ben4096/radpower-parts/README.md

# Radpower parts

Sharing models and instructions for discontinued parts.

> **Unofficial community project.** Not affiliated with, endorsed by or sponsored by Rad Power Bikes. "Radpower" and "Rad Power Bikes" are trademarks of their respective owner and are used here only to indicate compatibility. All models are original work, measured and drawn from scratch; no manufacturer drawings or files are included.

## Parts

Each part has its own folder with a README (machining notes, pictures) and its files (3D model, drawings).

| Part | Bike | Folder |
| --- | --- | --- |
| Derailleur hanger | RadWagon 3 (2019) | [radwagon-3-hanger](radwagon-3-hanger/) |

## Disclaimer

Parts on bicycles can be safety-relevant. Everything here is provided **as is, without any warranty**. Check every dimension against your own bike and original part before machining or ordering, and use it at your own risk.

## Licence

Models, drawings and instructions are released under
[Creative Commons Attribution-ShareAlike 4.0 International (CC BY-SA 4.0)](LICENSE).
You may use, machine, sell and modify them, provided you credit the author (ben4096) and share your modifications under the same licence.
