ben4096/radpower-parts/radwagon-3-hanger/radwagon-3-hanger.step

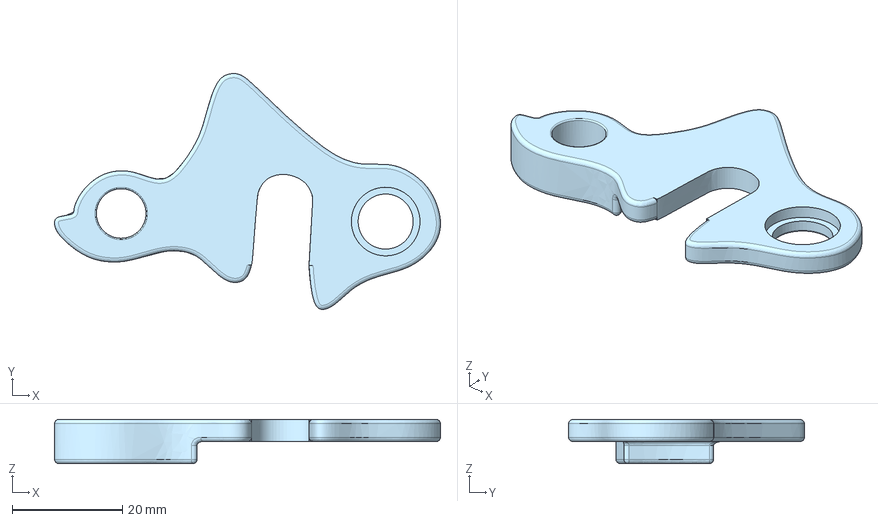
[picture p5: CAD file, 2026-10-23]
radwagon-3-hanger/radwagon-3-hanger.step
70.1 x 42.9 x 8.00 mm
