ben4096/radpower-parts/radwagon-3-hanger/radwagon-3-hanger-thread-drawing.pdf

# THREAD SPECIFICATION - RADWAGON-3-HANGER.STEP

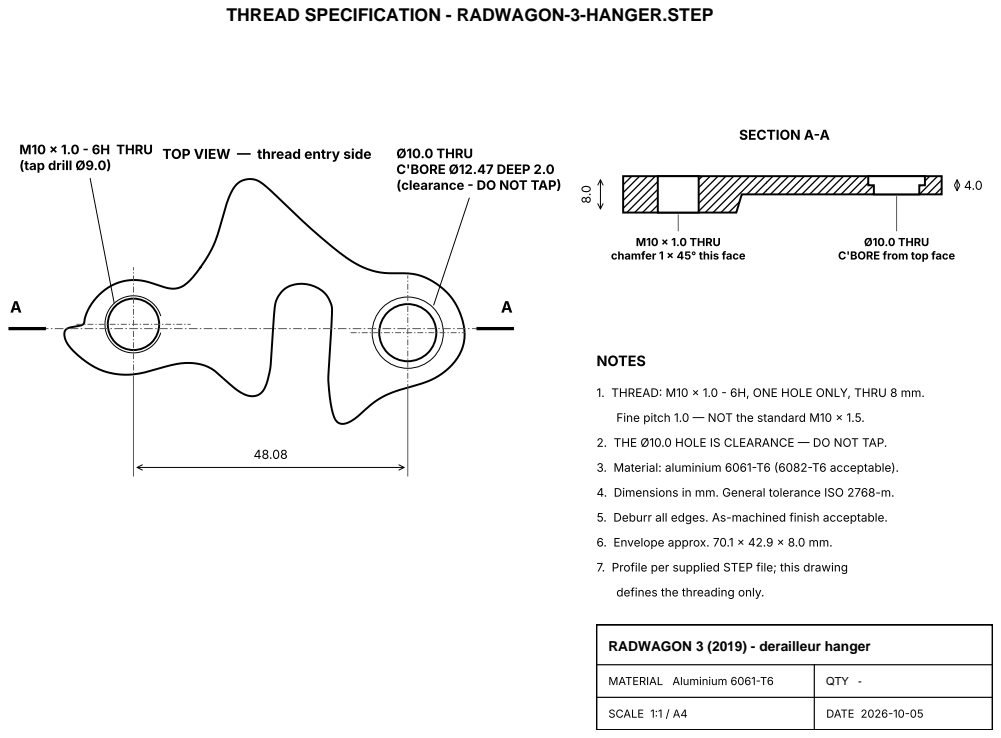
[picture p6: page 1]
M10 × 1.0 - 6H THRU (tap drill Ø9.0); SECTION A-A; NOTES; MATERIAL Aluminium 6061-T6; SCALE 1:1 / A4; DATE 2026-10-05; QTY -

TOP VIEW — thread entry side

Ø10.0 THRU
C'BORE Ø12.47 DEEP 2.0
(clearance - DO NOT TAP)

M10 × 1.0 THRU
chamfer 1 × 45° this face

C'BORE from top face

1. THREAD: M10 × 1.0 - 6H, ONE HOLE ONLY, THRU 8 mm.
Fine pitch 1.0 — NOT the standard M10 × 1.5.

2. THE Ø10.0 HOLE IS CLEARANCE — DO NOT TAP.

3. Material: aluminium 6061-T6 (6082-T6 acceptable).

4. Dimensions in mm. General tolerance ISO 2768-m.

5. Deburr all edges. As-machined finish acceptable.

6. Envelope approx. 70.1 × 42.9 × 8.0 mm.

7. Profile per supplied STEP file; this drawing

defines the threading only.

RADWAGON 3 (2019) - derailleur hanger
